Kyuubi0323/Wireless_Sensor_Network_20231/REFERENCE/Bluetooth Mesh_ The Ultimate Guide_files/MeshNetwork-6-resized-1.jpg

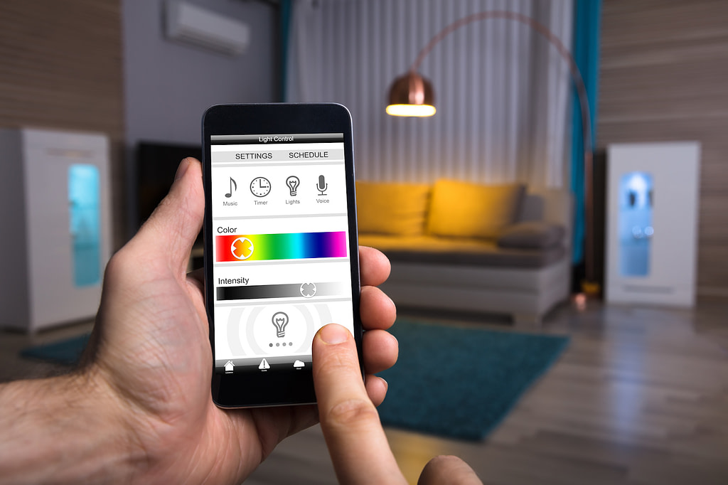
REFERENCE/Bluetooth Mesh_ The Ultimate Guide_files/MeshNetwork-6-resized-1.jpg
