Kyuubi0323/Wireless_Sensor_Network_20231/README.md

# Wireless_Sensor_Network_20231
#pca10056
