Kyuubi0323/Wireless_Sensor_Network_20231/Ảnh và Vid/ảnh thingsboard.png

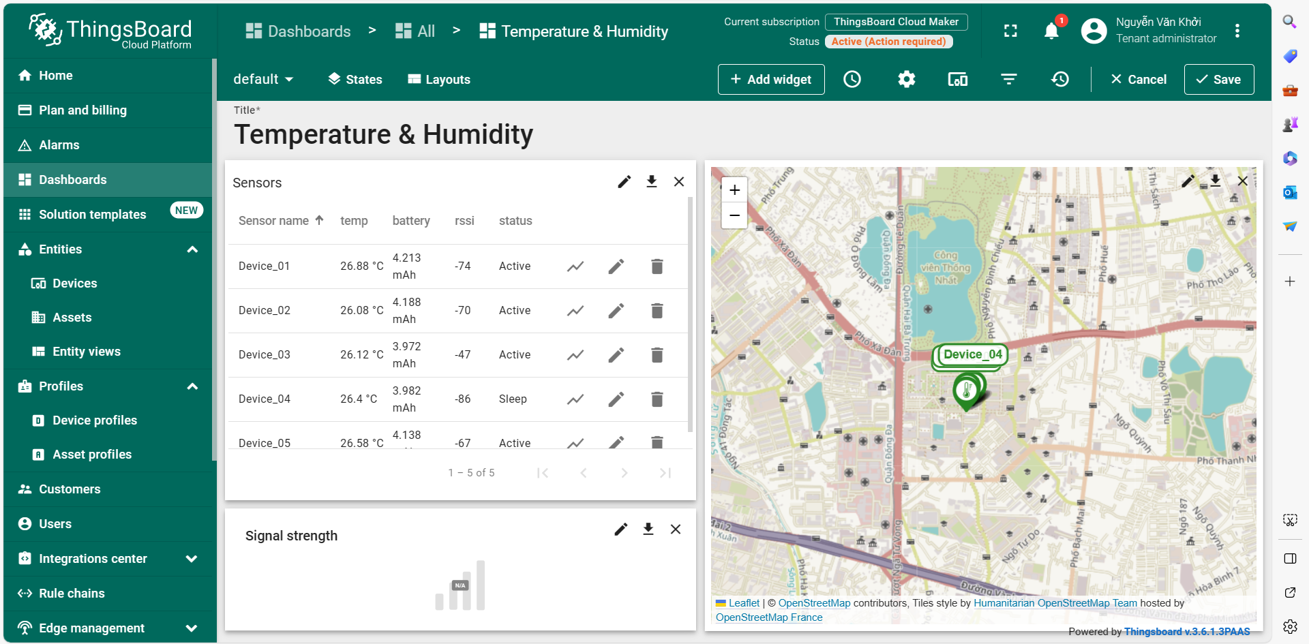
Ảnh và Vid/ảnh thingsboard.png
