Kyuubi0323/Wireless_Sensor_Network_20231/REFERENCE/Bluetooth Mesh_ The Ultimate Guide_files/50828b90799965fdefa32b778fc381a1.jpeg

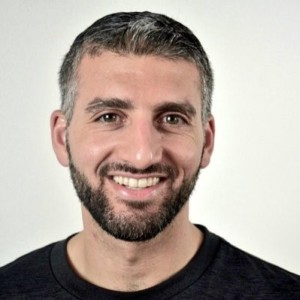
REFERENCE/Bluetooth Mesh_ The Ultimate Guide_files/50828b90799965fdefa32b778fc381a1.jpeg
