Kyuubi0323/Wireless_Sensor_Network_20231/REFERENCE/Bluetooth Mesh_ The Ultimate Guide_files/Bluetooth-Mesh-Guide.png

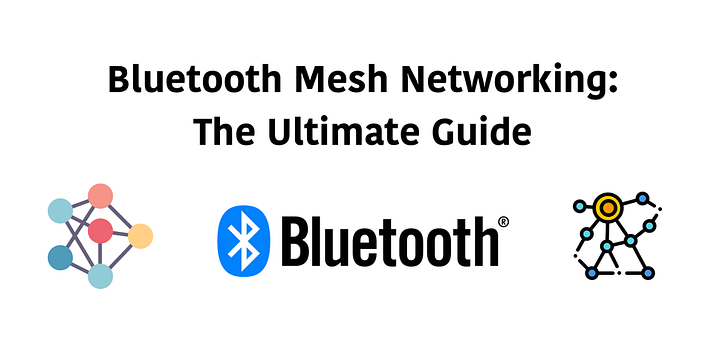
REFERENCE/Bluetooth Mesh_ The Ultimate Guide_files/Bluetooth-Mesh-Guide.png
