Kyuubi0323/Wireless_Sensor_Network_20231/(list of files, drawings)

Other design files:
HARDWARE/PCB_Project/PCB_Project.PrjPcb
HARDWARE/WSN_GATEWAY/GATEWAY/GATEWAY.PrjPcb
HARDWARE/WSN_GATEWAY/GATEWAY/Main.PcbDoc
HARDWARE/WSN_GATEWAY/GATEWAY/Main.SchDoc
HARDWARE/WSN_GATEWAY/GATEWAY/NODE.PrjPcb
HARDWARE/WSN_GATEWAY/GATEWAY/POWER.SchDoc
HARDWARE/WSN_NODE/NODE/CONN.SchDoc
HARDWARE/WSN_NODE/NODE/Display.SchDoc
HARDWARE/WSN_NODE/NODE/Main.SchDoc
HARDWARE/WSN_NODE/NODE/NODE.PcbDoc
HARDWARE/WSN_NODE/NODE/NODE.PrjPcb
HARDWARE/WSN_NODE/NODE/Power.SchDoc
HARDWARE/WSN_NODE/NODE/Sensor.SchDoc
HARDWARE/WSN_NODE_V1.1/WSN_V1.1/CONN.SchDoc
HARDWARE/WSN_NODE_V1.1/WSN_V1.1/Display.SchDoc
HARDWARE/WSN_NODE_V1.1/WSN_V1.1/Main.SchDoc
HARDWARE/WSN_NODE_V1.1/WSN_V1.1/Power.SchDoc
HARDWARE/WSN_NODE_V1.1/WSN_V1.1/Sensor.SchDoc
HARDWARE/WSN_NODE_V1.1/WSN_V1.1/WSN_v1.1.PrjPcb
REFERENCE/nrf52840/40AL..08.pcbdoc
REFERENCE/nrf52840/840P..08.schdoc
