Kyuubi0323/Wireless_Sensor_Network_20231/(commit log)

2023-10-11 add SDK files
    [GATEWAY.PrjPcb, POWER.SchDoc, config.txt]
2023-10-12 SoC datasheet
    [40AL..08.pcbdoc, 840P..08.schdoc]
2023-10-23 done schematic
    [Display.SchDoc, Main.SchDoc, NODE.PrjPcb, POWER.SchDoc, Sensor.SchDoc]
2023-10-24 draft v1
    [Display.SchDoc, Main.SchDoc, NODE.PrjPcb, POWER.SchDoc, Sensor.SchDoc]
2023-11-09 Let's layout
    [Display.SchDoc, Main.SchDoc, NODE.PrjPcb, Power.SchDoc, Sensor.SchDoc]
2023-11-10 done PCB
    [Power.SchDoc]
2023-11-13 done ver1_0
    [Main.SchDoc, NODE.PrjPcb, NODE_v1.1.PcbDoc, Power.SchDoc]
2023-12-01 v1.1 done
    [CONN.SchDoc, Display.SchDoc, Main.SchDoc, Power.SchDoc, Sensor.SchDoc, WSN_v1.1.PrjPcb]
2023-12-11 new new
    [GATEWAY.PrjPcb]
2023-12-15 gateway done
    [Display.SchDoc, GATEWAY.PrjPcb, Main.PcbDoc, Main.SchDoc, POWER.SchDoc, Sensor.SchDoc]
2024-01-20 Added Flow_Chart.drawio
2024-01-22 Added Flow_Chart.png
